OpenBioprinting/OpenLab/README.md

# OpenLab
Open Lab Tools for science

More documentation: http://openbioprinting.org/open-lab/
