OpenBioprinting/OpenLab/paste_extruder_HP2/README.md

CC-4.0-SA
Jan2019 Nicuma3

Derivative of "Harry's Paste Extruder by yoursstreuli Apr 3, 2015" at https://www.thingiverse.com/thing:754436 and "Greg wade accessible extruder/ AB_design by AB-Design Apr 20, 2018" https://www.thingiverse.com/thing:2868510

Adaptable to Prusa Hephestos 1 - BQ (https://www.bq.com/es/support/hephestos/support-sheet and https://github.com/bq/prusa-i3-hephestos)

### BOM (Bill of materials):

  - 1 x NEMA 17 step driver
  - 2 x M4xL70 mm threaded rod (DIN 975)
  - 1 x M4xL20 mm threaded rod (DIN 975)

  - 6 x M8 washer (DIN 125)
  - 4 x M4 Large OD washer (oversize) (DIN 9021)

  - 2 x M4 Wingnut (DIN 315)

  - 1 x M8xL60 mm bolt (DIN 933) - MUST BE CHAMFERED/MECHANIZE!

  - 1 x M3xL30 mm bolt (DIN 912)
  - 2 x M3xL40 mm bolt (DIN 912)

  - 3 x M3 nut (DIN 934)
  - 2 x M4 nut (DIN 934)

  - 1 x M3xL8 mm socket set screw (DIN 916)

  - 1 x M8 Hex lock nut (DIN 985)

  - 2 x Axial bearing 608zz (DIN 625)
  - 1 x Axial bearing 624zz (DIN 625)

  - 2 x springs 18x4mm (REF missing)

  - 6 Printed parts:
 	  - adapted internal gear
	  - base_support
	  - spring_press
	  - herringbone_large_gear
	  - heringbone_small_gear
	  - plunge

Assembly and more info at: openbioprinting.org
