OpenBioprinting/OpenLab/paste_extruder_HP2/drawings/readme.txt

The construction and assembly of the extruder is explained also here with subset drawings, that can also help with the manufacture of the extruder.
