OpenBioprinting/OpenLab/paste_extruder_HP2/Documentation/config_extruder.pdf

diy bioprinter: assembly and calibration

b.2 assembly

The assembly of the extruder is explained in the next pages, with subset drawings. Also, an interactive 3D model of the complete assemblied extruder can be consulted online:
https://a360.co/2EwcIV1.

b.3 calibration and software adaptation

To be able to work with the new extruder in any printer, we need to obtain some basic data from the mechanical transmission, to obtain the steps per unit. This is a parameter present in all the axis or a normal 3D printer that works with stepper motors. It represents how much must rotate the stepper motor to obtain a movement of 1 mm at the end of the transmision. For example, when the x, y or z-axis moves 1 mm. This number can be calculated following the movement of the mechanical parts conected to the motor.

In our case, the motor (which rotates 1.8◦per step) moves solidary with a small herringbone (double helical) gear [Piece 5]. Then a reduction system transforms this movement into a smaller rotation, but with higher torque. Solidary to this big herringbone gear [Piece 6], is a pinion [Piece 3] that translates the rotational movement to a linear one, thanks to a pinion-rack system. This rack [Piece 4] will act as the plunge that will press the syringe. Therefore, this is the final element of the transmission, the one that should move 1 mm.

The calculations requiered to obtain the number of steps that the motor must rotate to achieve this movement (steps_per_unit) are reflected in Figure B.1.

148

B.3 calibration and software adaptation

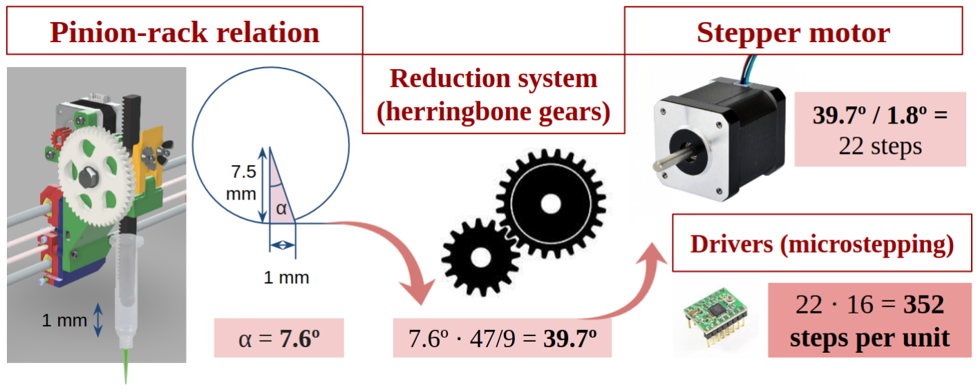
[picture p1: figure]

Figure B.1: Transmision movement scheme to calculate the ’steps per unit’ for the extruder motor. It may change for other printers microstepping.

b.3.1 Firmware adaptation - MARLIN

Marlin is composed by many files and libraries. In our case, we only need to use a Marlin adapted to our printer model, and made some chages at ’Configuration.h’.

1. # define TEMP_SENSOR_0 to 998: this will tell the printer that the current temperature of the extruder is 25 ◦C always. This is necessary to print, as we do not use the heating, neither the temperature sensor of the extruder.
2. # define EXTRUDE_MINTEMP to 20: to remove the limitation of printing only over 170 ◦C, that is normally preinstalled in the printers.
3. # define INVERT_E0_DIR to false: Only when necessary, if the extruder is moving in the opposite direction.
4. # define Z_RAISE_BEFORE_HOMING to n: tto avoid collision, if transwells or any other recipient is used for bioprinting. This can also be changed at ’Start G-Code’ inside the slicing software.
5. # define DEFAULT_AXIS_STEPS_PER_UNIT (x,y,z, E): where (x,y,z) is given by default depending on the printer model and E is changed

149 diy bioprinter: assembly and calibration

to 352² to set up the correct volume deposition. This number is given by the movement translation from the rotating advance of the stepper motor to the linear movement of the plundge that press the syringe with the paste, as explained in Figure B.1.

b.3.2 Slicing program - Cura

This annex will describe the configuration requiered in the slicing software (Cura, Ultimaker) to generate the trajectories (.gcodes) and deposit the correct volume of paste.

In the first place, we need to access the printer settings menu and change the configuration of the ’compatible filament diameter’ to 18 mm, which is normally the diameter of the 10 cc cartridge / syringe.

The, at Filament menu, we introduce again this number (18 mm) where the size of the filament plastic used is normally configured. We need to change also the temperature required for the thermoplastic melting to the 25◦C, and configure the temperature of the hot base if required.

In the printing menu configuration we need to check also some submenus:

– Retraction: The cartridge diameter, which along with the mm extruded give us the volume of material that enters in the system. In our case, the Nordson cartridges are set to 18 mm.
– Bed temperature: 37 ◦C, if cells are present.
– Layer height: 65% of the noozle/needle tip diameter.
– Retraction: Disabled, to avoid the introduction of air inside the cartridges

2 This number can change if other microstepping relation is used by the printer electronics board.

150
