OpenBioprinting/OpenLab/paste_extruder_HP2/plunge barrel 10 cc.stl

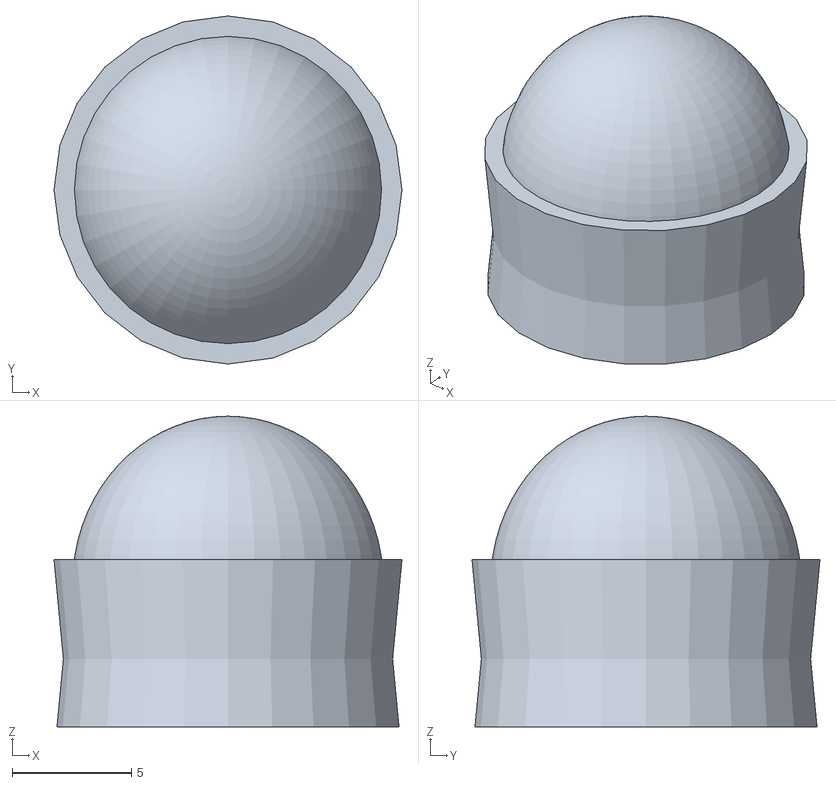
[picture p2: CAD file, 2019-07-03]
paste_extruder_HP2/plunge barrel 10 cc.stl
14.6 x 14.6 x 13.0
