OpenBioprinting/OpenLab/paste_extruder_HP2/taper tip.stl

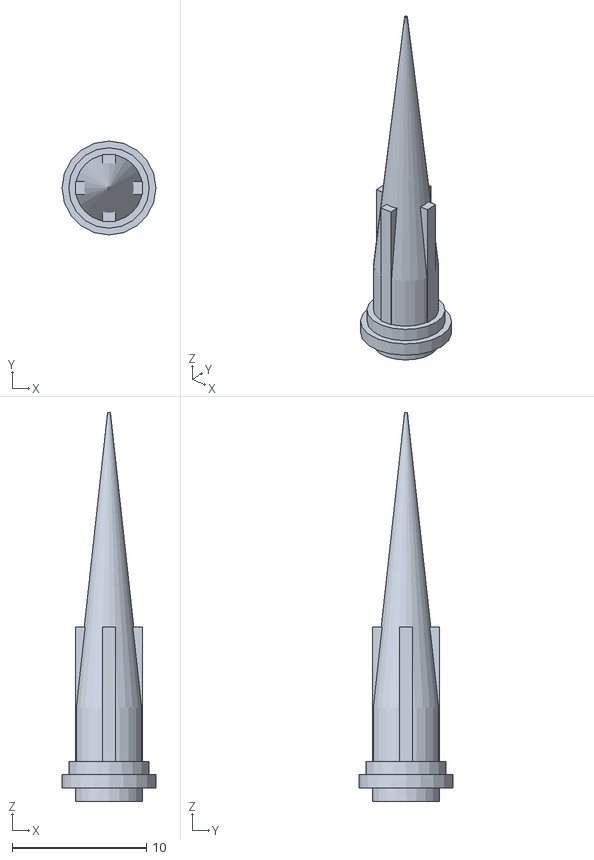
[picture p3: CAD file, 2019-07-03]
paste_extruder_HP2/taper tip.stl
7.00 x 7.00 x 29.0
