OpenBioprinting/OpenLab/paste_extruder_HP2/adapted_internal_gear.stl

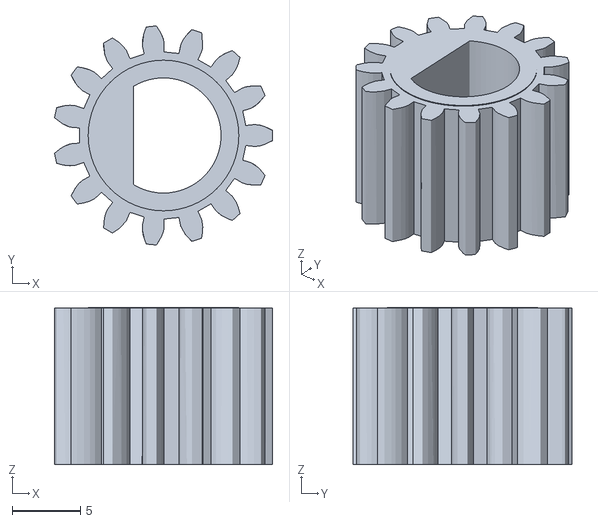
[picture p4: CAD file, 2019-07-03]
paste_extruder_HP2/adapted_internal_gear.stl
15.9 x 16.0 x 11.5
