OpenBioprinting/OpenLab/paste_extruder_HP2/base_support.stl

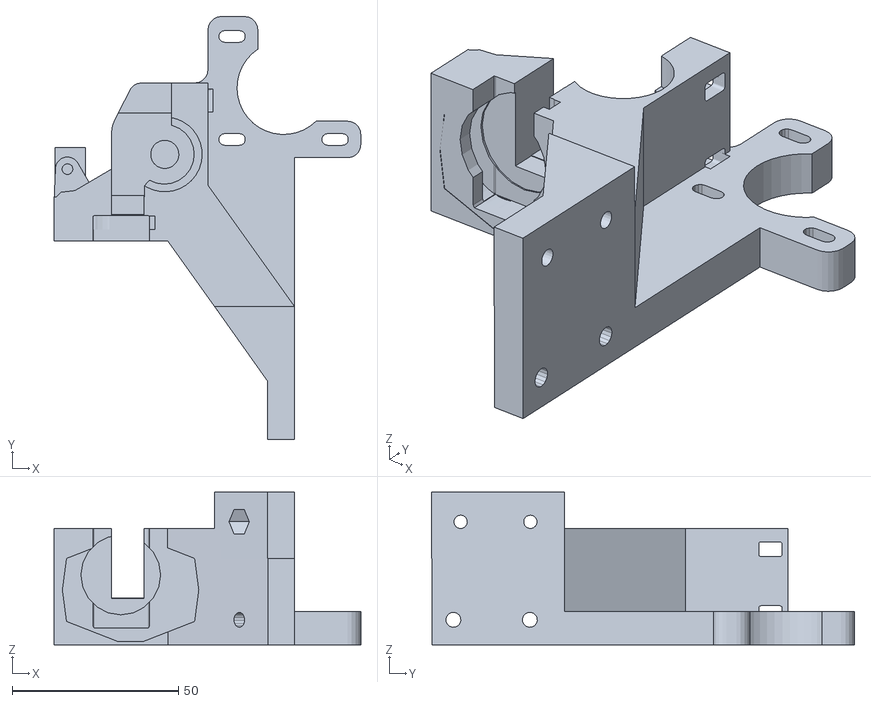
[picture p5: CAD file, 2019-07-02]
paste_extruder_HP2/base_support.stl
92.3 x 127.3 x 45.9
