OpenBioprinting/OpenLab/paste_extruder_HP2/herringbone_large_gear.stl

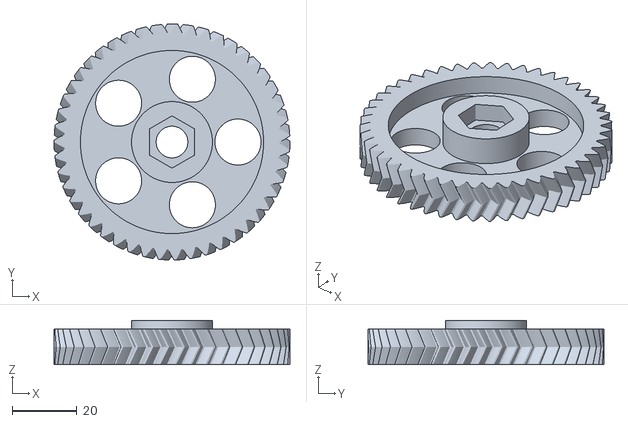
[picture p6: CAD file, 2019-07-02]
paste_extruder_HP2/herringbone_large_gear.stl
73.0 x 73.0 x 13.8
