OpenBioprinting/OpenLab/paste_extruder_HP2/herringbone_small_gear.stl

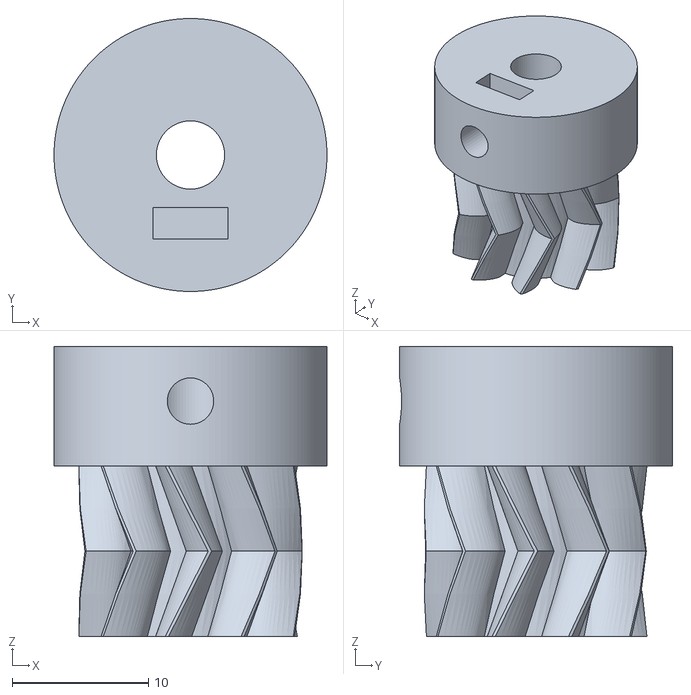
[picture p7: CAD file, 2019-07-02]
paste_extruder_HP2/herringbone_small_gear.stl
20.0 x 20.0 x 21.2
