OpenBioprinting/OpenLab/paste_extruder_HP2/spring_press.stl

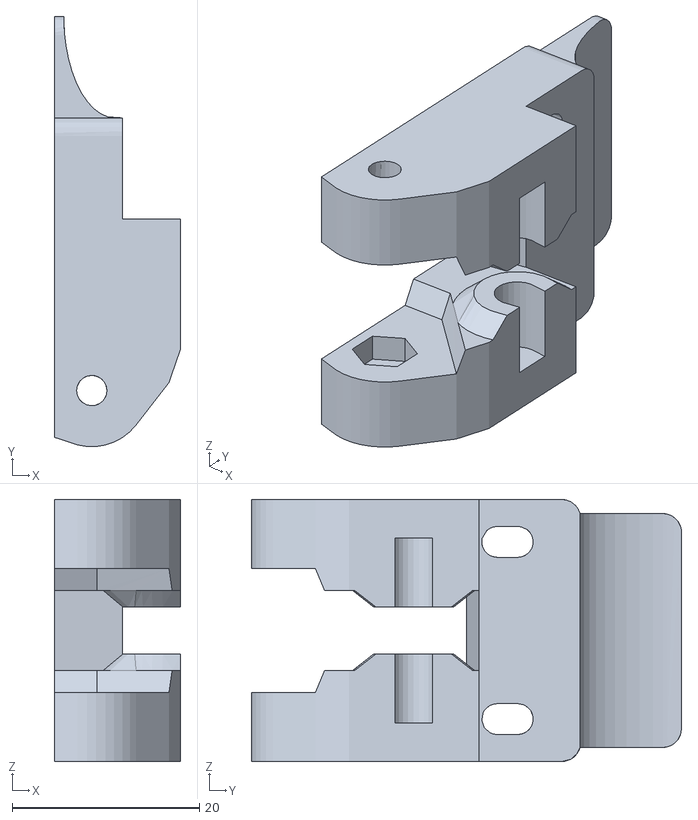
[picture p8: CAD file, 2019-07-02]
paste_extruder_HP2/spring_press.stl
13.5 x 46.0 x 28.0
