OpenBioprinting/OpenLab/paste_extruder_HP2/plunge.stl

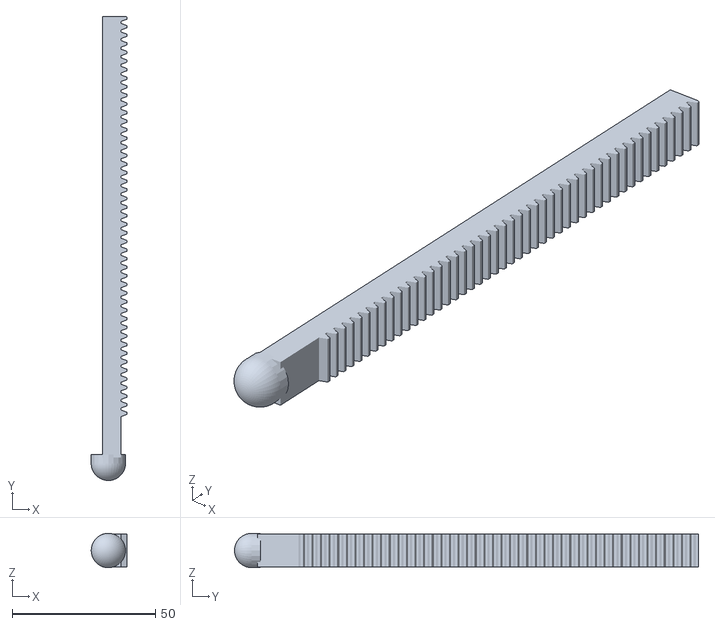
[picture p9: CAD file, 2019-07-02]
paste_extruder_HP2/plunge.stl
12.5 x 162.0 x 12.0
