OpenBioprinting/OpenLab/paste_extruder_HP2/drawings/10-Spring_Press_Color.pdf

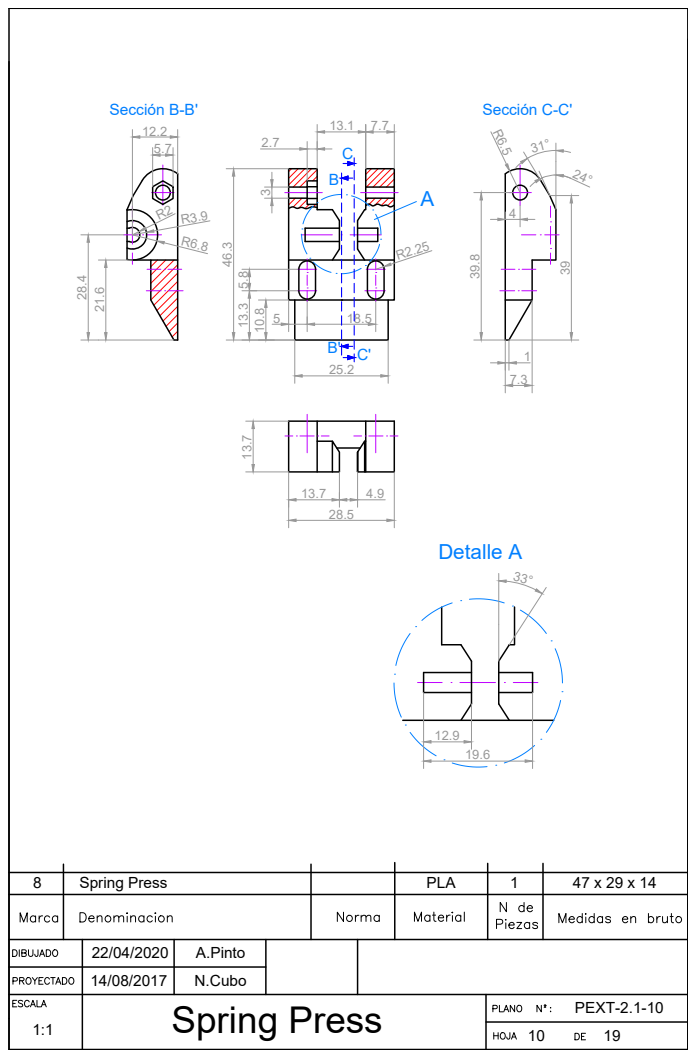
[picture p10: page 1]
Spring Press; Detalle A; Sección C-C'; Sección B-B'

22/04/2020 | A.Pinto

14/08/2017 | N.Cubo
