OpenBioprinting/OpenLab/paste_extruder_HP2/drawings/11-Stepper_Motor_Color.pdf

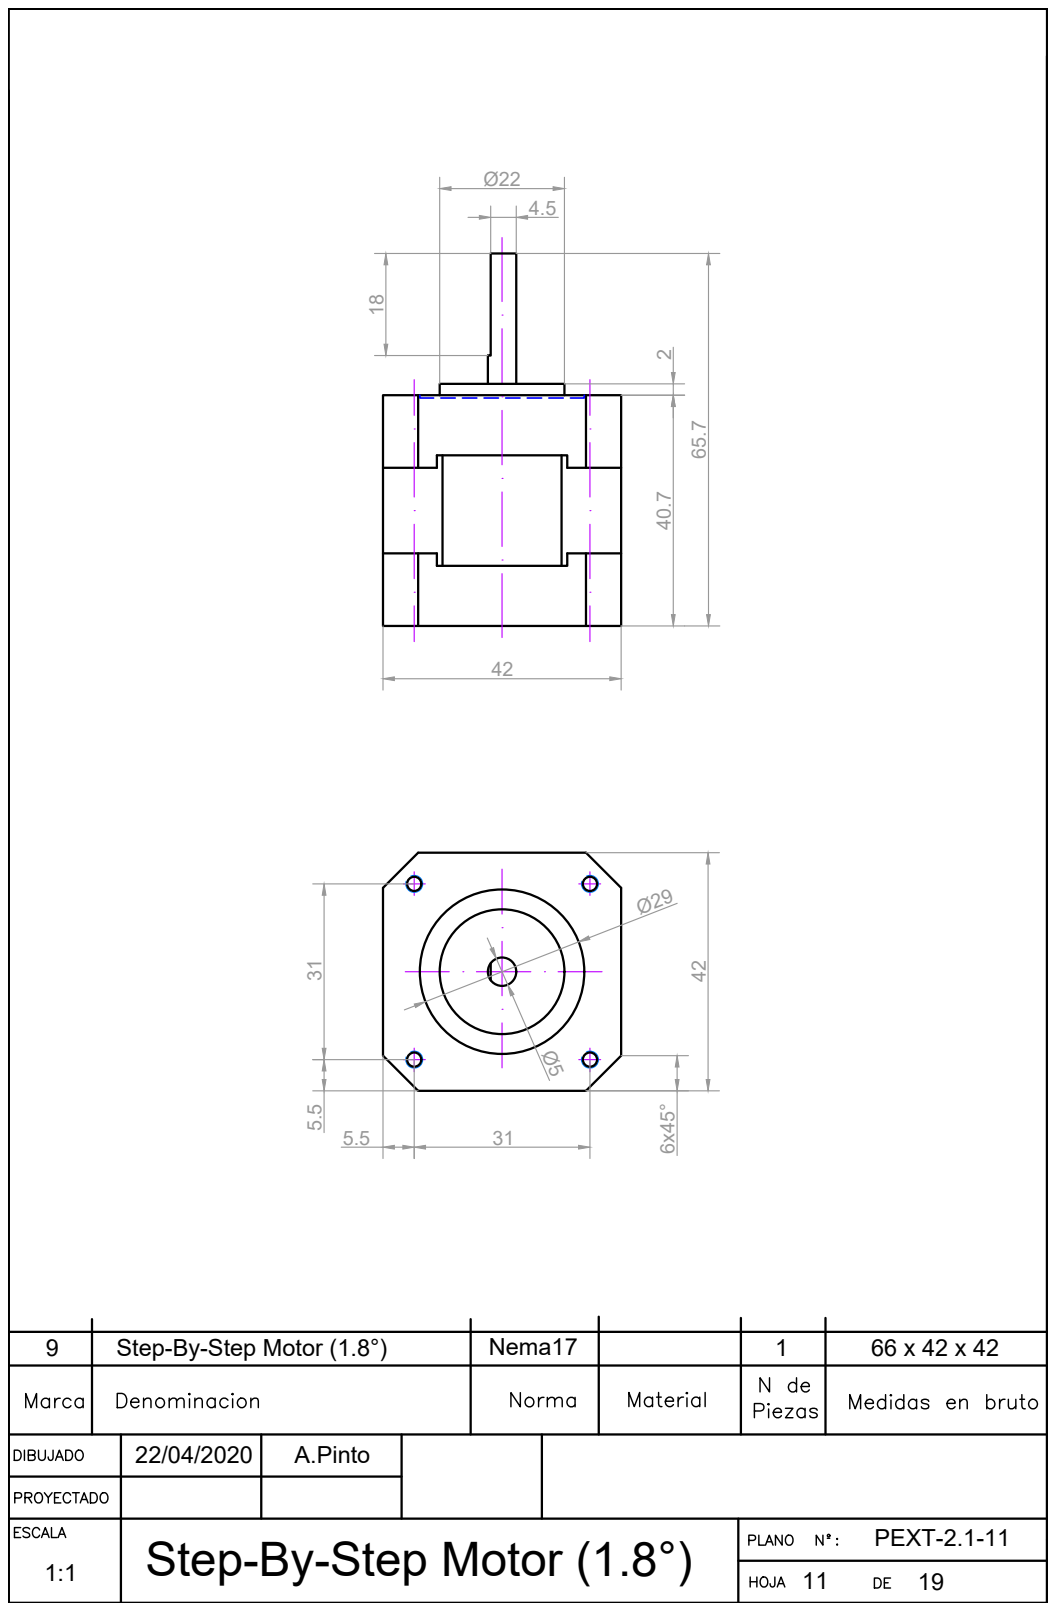
[picture p11: page 1]
Step-By-Step Motor (1.8°) 42

Step-By-Step Motor (1.8°)
