OpenBioprinting/OpenLab/paste_extruder_HP2/drawings/12-Normalized_Elements_1_Color.pdf

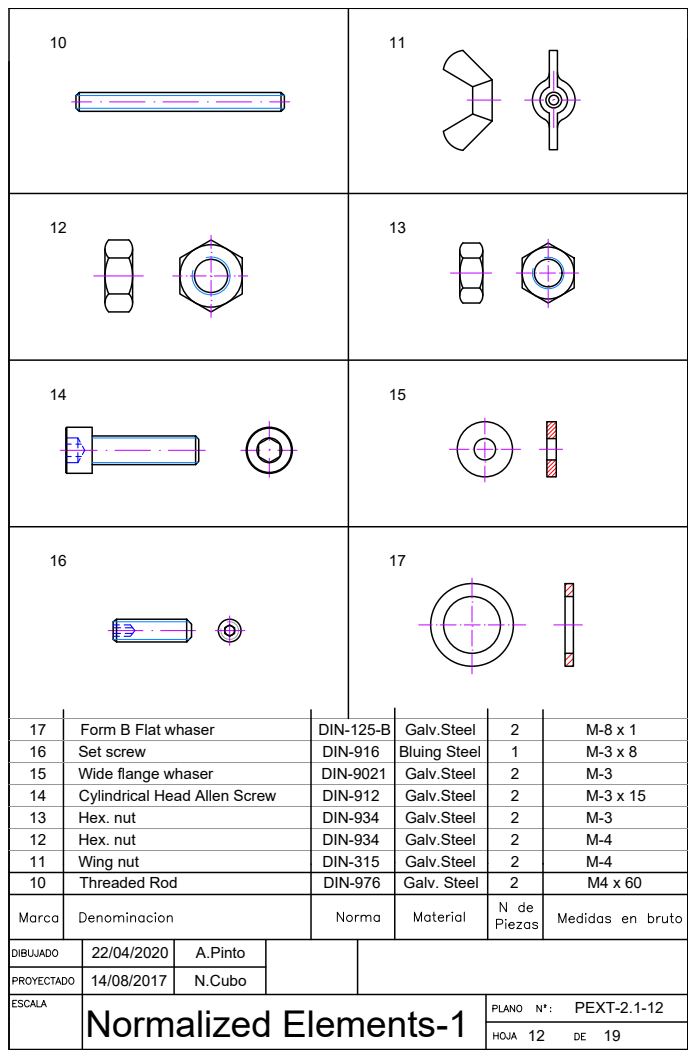
[picture p12: page 1]
Normalized Elements-1

17 | Form B Flat whaser | DIN-125-B | Galv.Steel | 2 | M-8 x 1
16 | Set screw | DIN-916 | Bluing Steel | 1 | M-3 x 8
15 | Wide flange whaser | DIN-9021 | Galv.Steel | 2 | M-3
14 | Cylindrical Head Allen Screw | DIN-912 | Galv.Steel | 2 | M-3 x 15
13 | Hex. nut | DIN-934 | Galv.Steel | 2 | M-3
12 | Hex. nut | DIN-934 | Galv.Steel | 2 | M-4
11 | Wing nut | DIN-315 | Galv.Steel | 2 | M-4
10 | Threaded Rod | DIN-976 | Galv. Steel | 2 | M4 x 60

22/04/2020 | A.Pinto

14/08/2017 | N.Cubo
