OpenBioprinting/OpenLab/paste_extruder_HP2/drawings/13-Normalized_Elements_2_Color.pdf

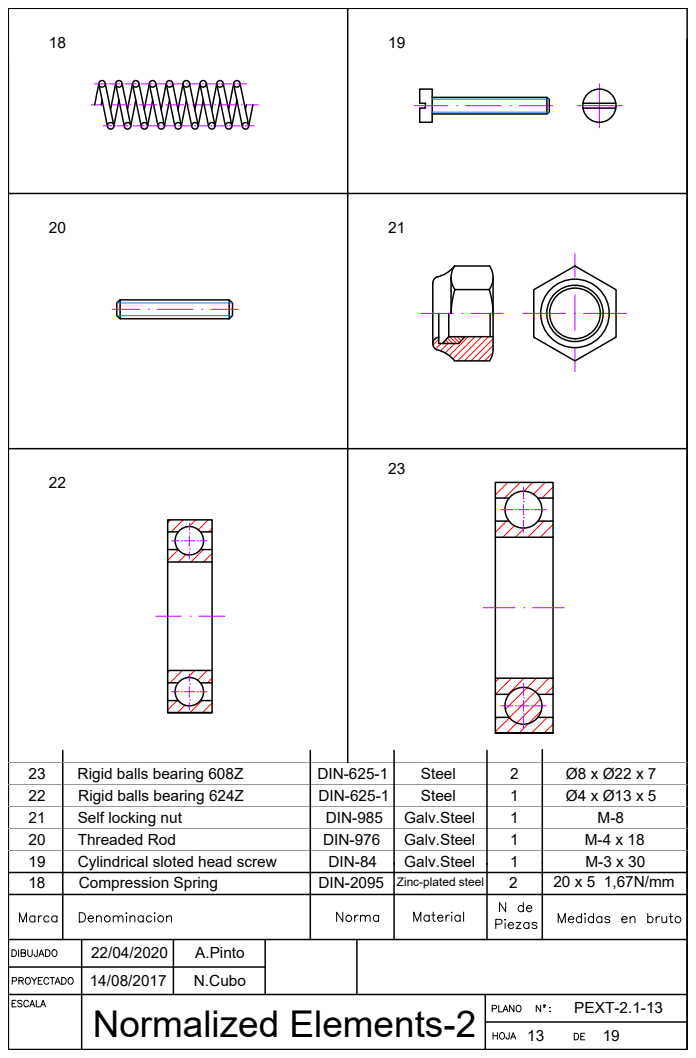
[picture p13: page 1]
Normalized Elements-2

23 | Rigid balls bearing 608Z | DIN-625-1 | Steel | 2 | Ø8 x Ø22 x 7
22 | Rigid balls bearing 624Z | DIN-625-1 | Steel | 1 | Ø4 x Ø13 x 5
21 | Self locking nut | DIN-985 | Galv.Steel | 1 | M-8
20 | Threaded Rod | DIN-976 | Galv.Steel | 1 | M-4 x 18
19 | Cylindrical sloted head screw | DIN-84 | Galv.Steel | 1 | M-3 x 30
18 | Compression Spring | DIN-2095 | Zinc-plated steel | 2 | 20 x 5 1,67N/mm

22/04/2020 | A.Pinto

14/08/2017 | N.Cubo
