OpenBioprinting/OpenLab/paste_extruder_HP2/drawings/14-Subset_1_Color.pdf

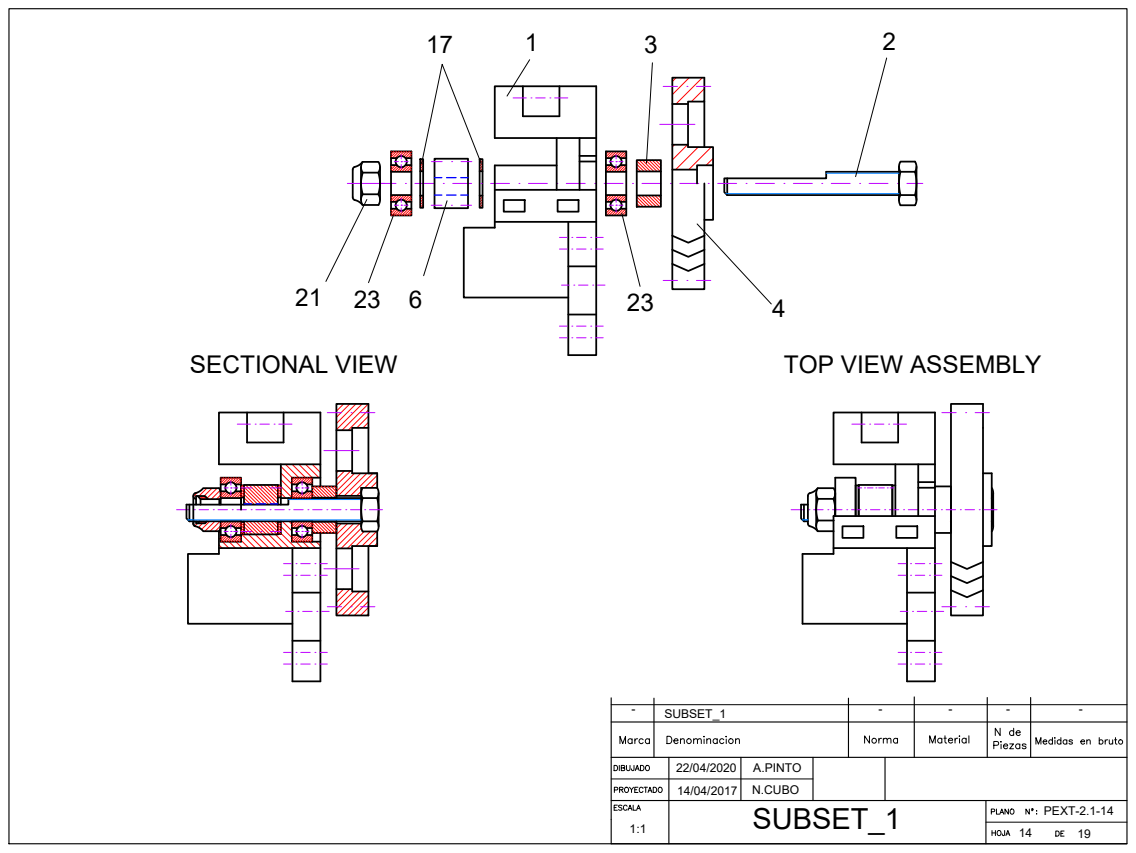
[picture p14: page 1]
SECTIONAL VIEW; TOP VIEW ASSEMBLY
