OpenBioprinting/OpenLab/paste_extruder_HP2/drawings/15-Subset_2_Color.pdf

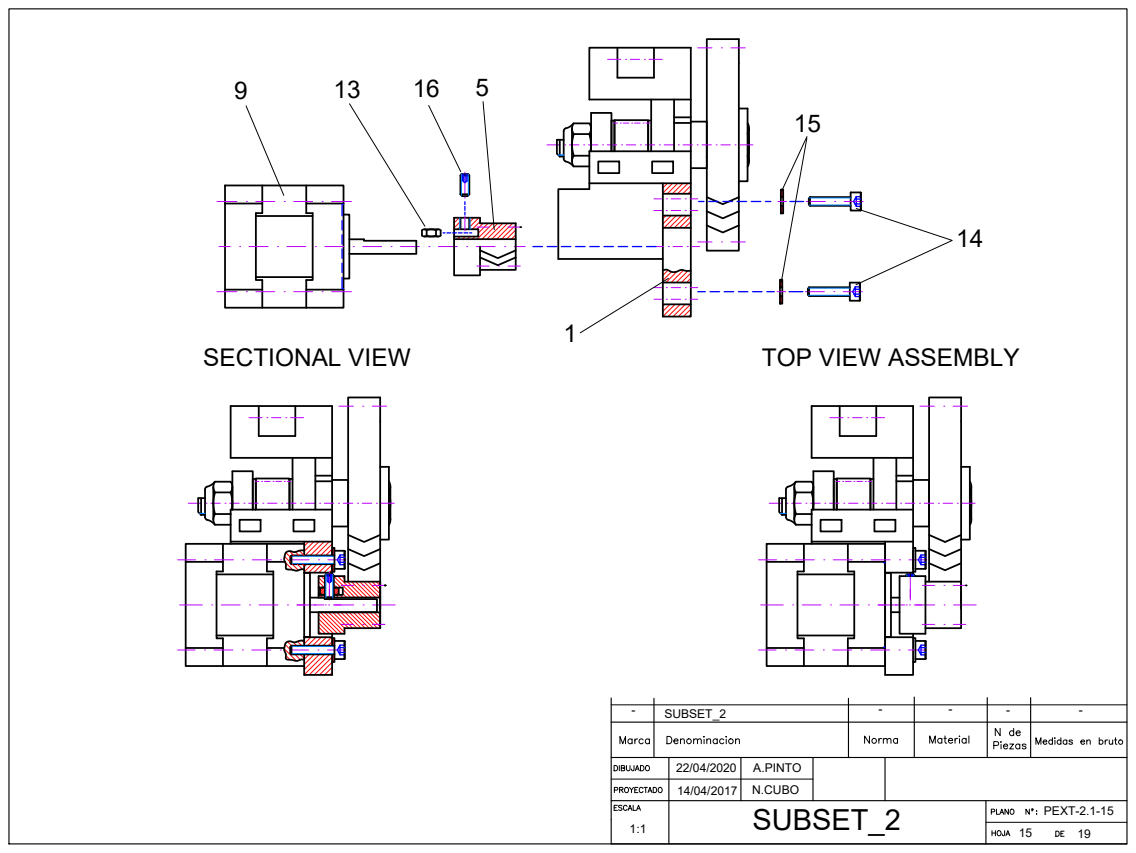
[picture p15: page 1]
SECTIONAL VIEW; TOP VIEW ASSEMBLY
