OpenBioprinting/OpenLab/paste_extruder_HP2/drawings/16-Subset_3_Color.pdf

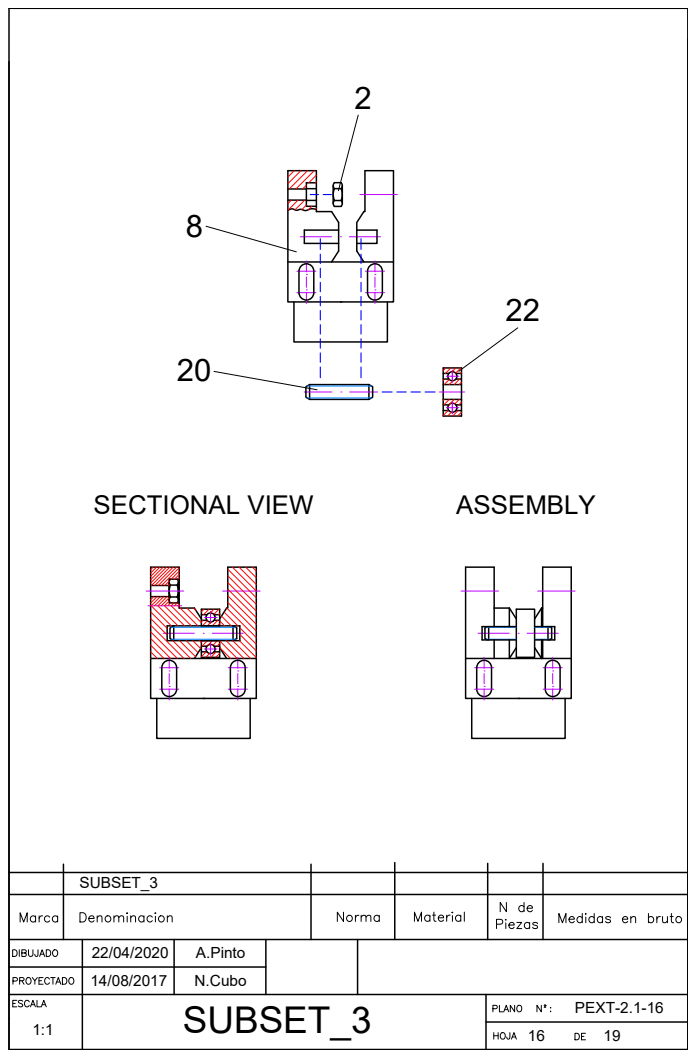
[picture p16: page 1]
SECTIONAL VIEW; ASSEMBLY

22/04/2020 | A.Pinto

14/08/2017 | N.Cubo
