OpenBioprinting/OpenLab/paste_extruder_HP2/drawings/17-Subset_4_Color.pdf

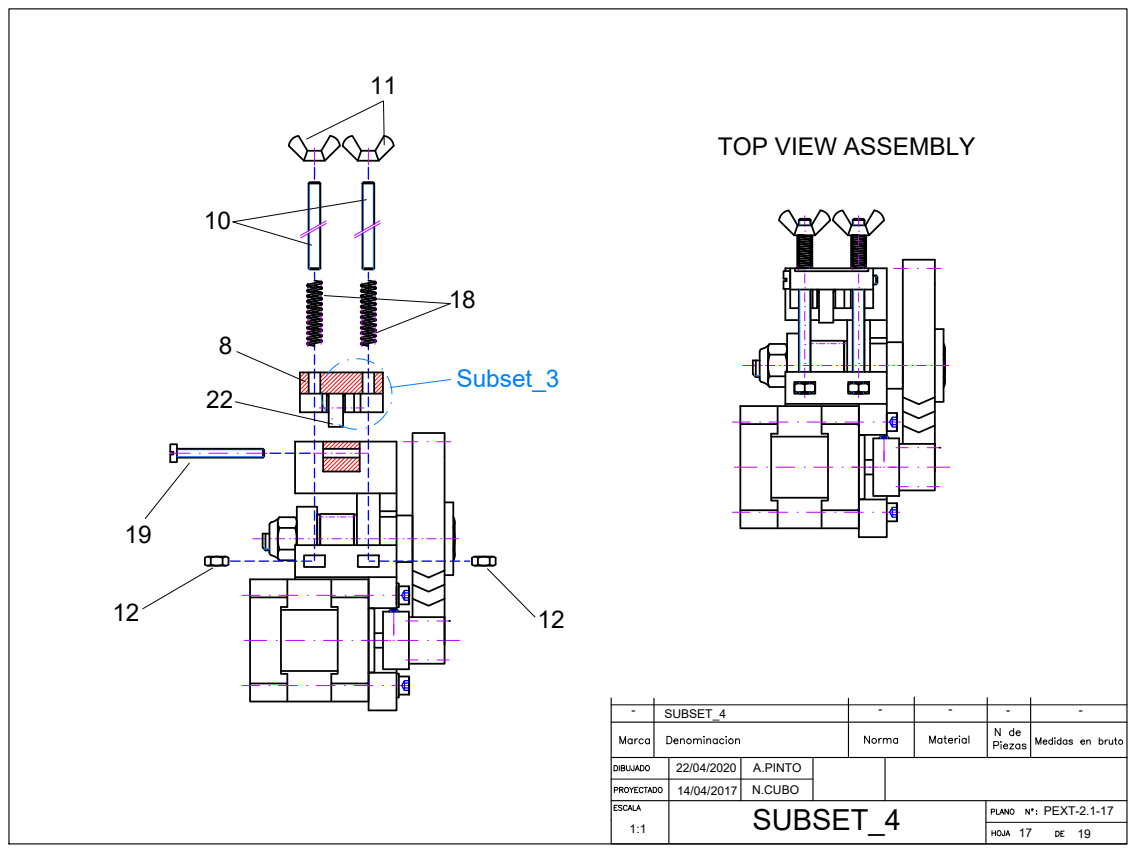
[picture p17: page 1]

TOP VIEW ASSEMBLY
