OpenBioprinting/OpenLab/paste_extruder_HP2/drawings/18-Subset_5_Color.pdf

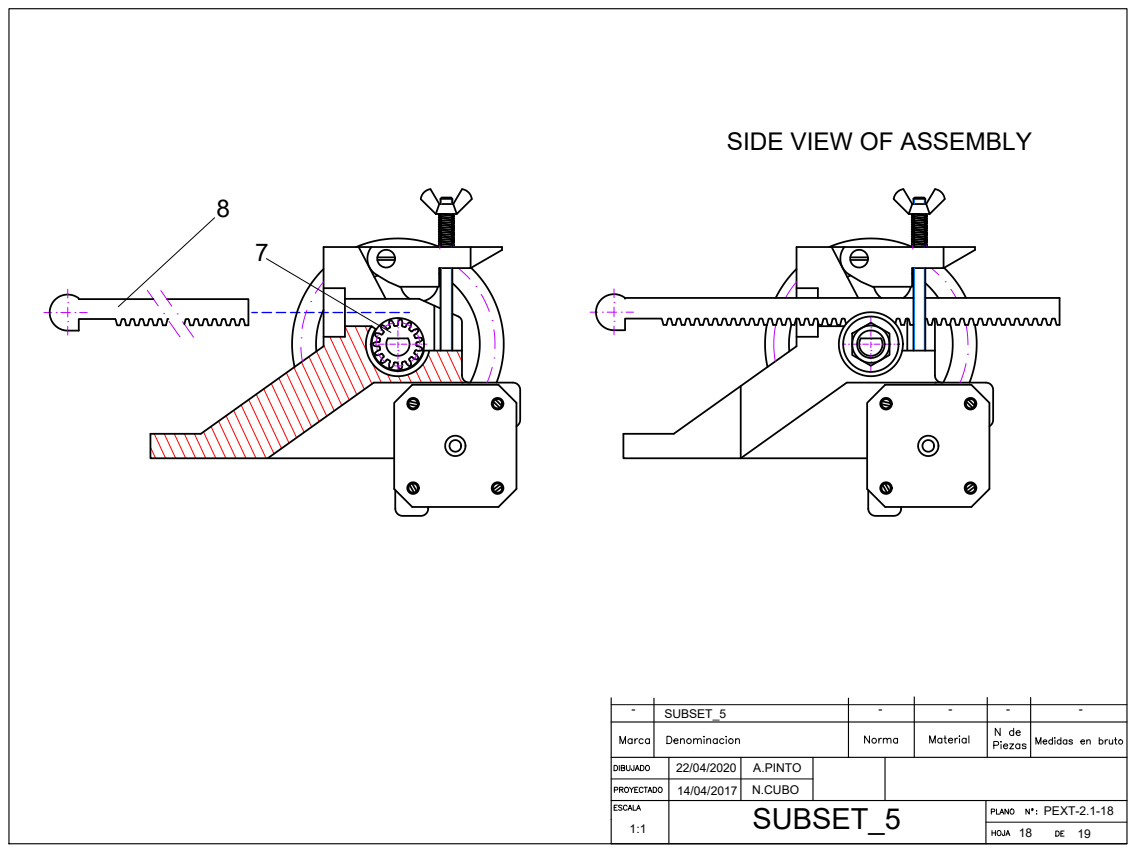
[picture p18: page 1]

SIDE VIEW OF ASSEMBLY
