OpenBioprinting/OpenLab/paste_extruder_HP2/drawings/2-Milled_Screw_Color.pdf

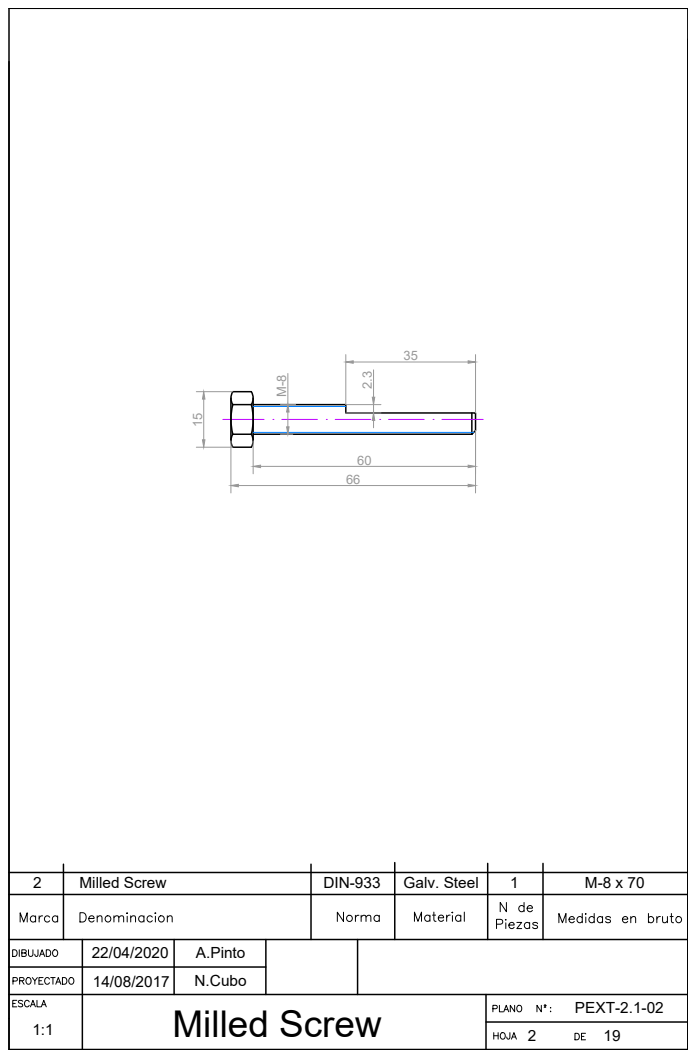
[picture p19: page 1]
DIN-933; Galv. Steel; Milled Screw

22/04/2020 | A.Pinto

14/08/2017 | N.Cubo
