OpenBioprinting/OpenLab/paste_extruder_HP2/drawings/6-Motor_Transmission_Color.pdf

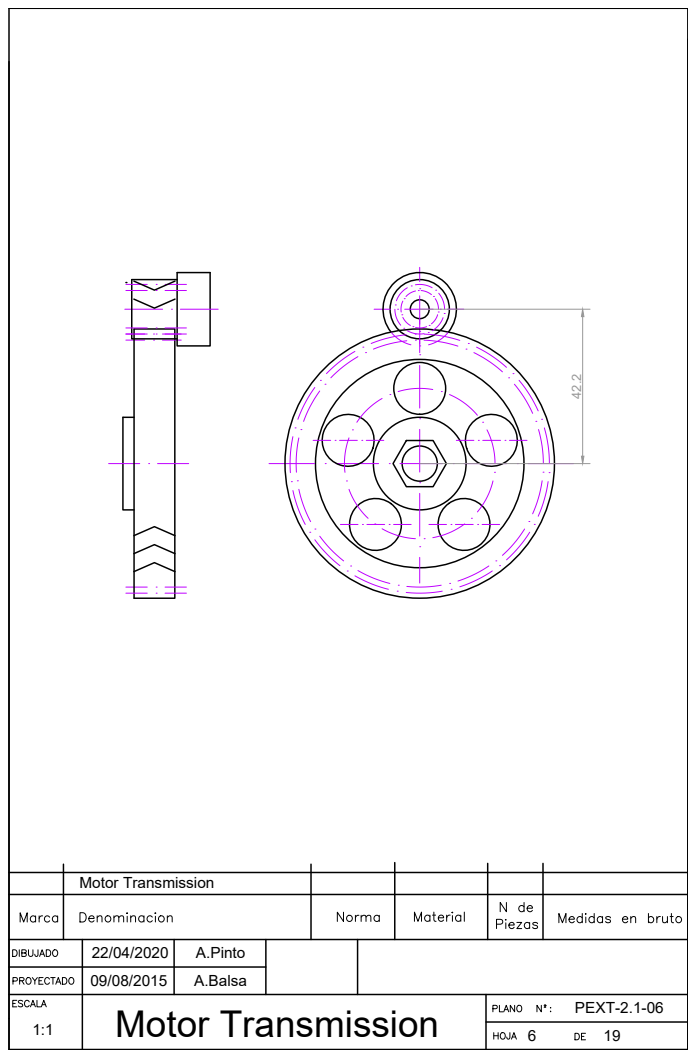
[picture p21: page 1]
Motor Transmission

22/04/2020 | A.Pinto

09/08/2015 | A.Balsa
