OpenBioprinting/OpenLab/paste_extruder_HP2/drawings/19-Extruder_Assembly_Color.pdf

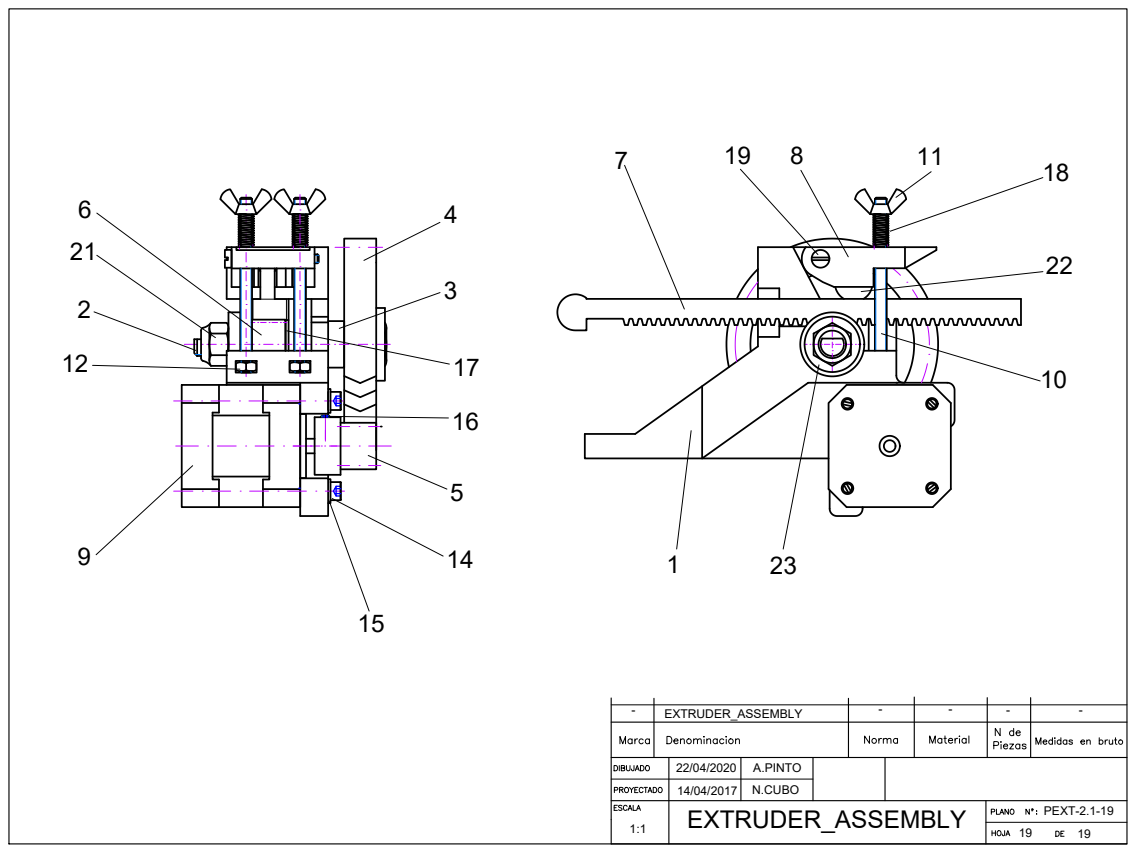
[picture p22: page 1]
