OpenBioprinting/OpenLab/paste_extruder_HP2/drawings/1-Base_Support_Color.pdf

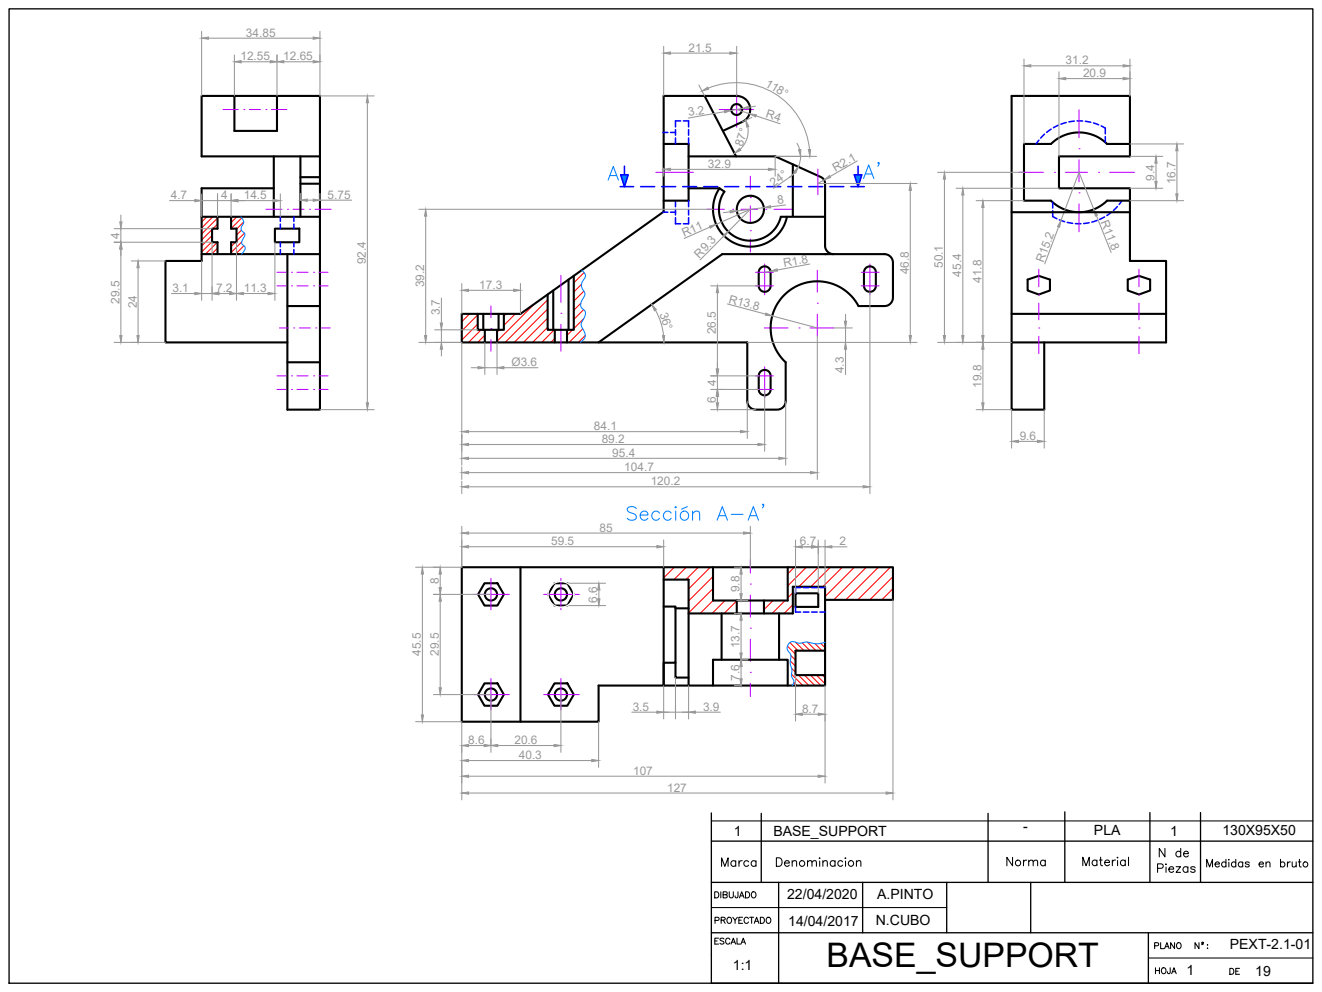
[picture p23: page 1]

22/04/2020 | A.PINTO
1:1 | BASE_SUPPORT | PEXT-2.1-01

14/04/2017 | N.CUBO
