OpenBioprinting/OpenLab/paste_extruder_HP2/drawings/3-Spacer_Color.pdf

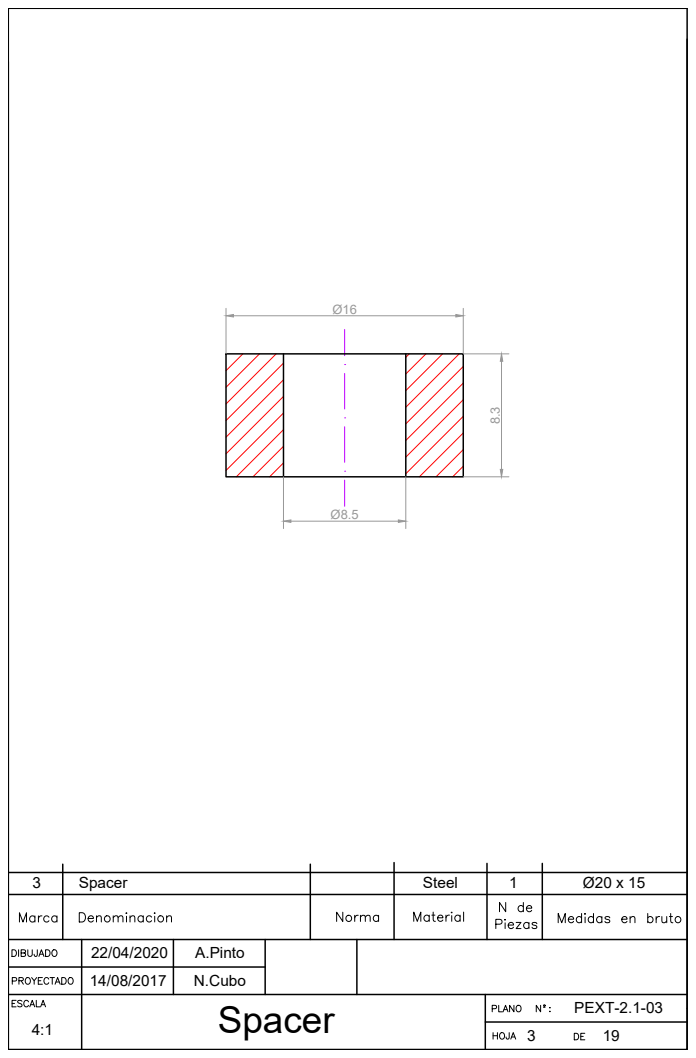
[picture p24: page 1]

22/04/2020 | A.Pinto

14/08/2017 | N.Cubo
