OpenBioprinting/OpenLab/paste_extruder_HP2/drawings/5-Small_Gear_Color.pdf

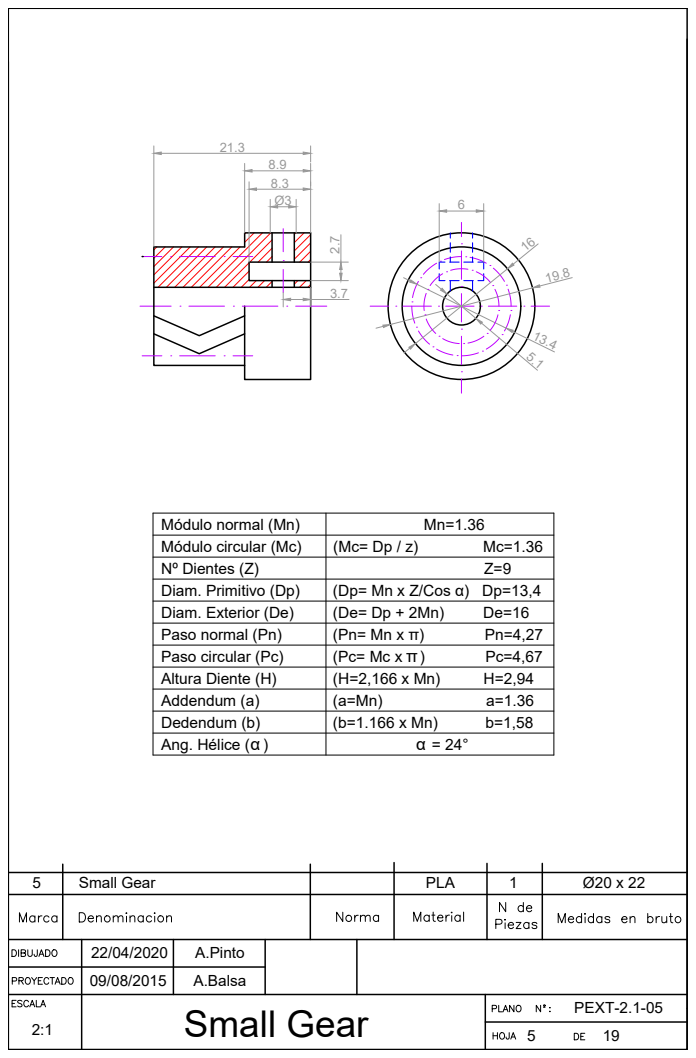
[picture p25: page 1]
Small Gear

Módulo normal (Mn) | Mn=1.36
Módulo circular (Mc) | (Mc= Dp / z) Mc=1.36
Nº Dientes (Z) | Z=9
Diam. Primitivo (Dp) | (Dp= Mn x Z/Cos α) Dp=13,4
Diam. Exterior (De) | (De= Dp + 2Mn) De=16
Paso normal (Pn) | (Pn= Mn x π) Pn=4,27
Paso circular (Pc) | (Pc= Mc x ) π Pc=4,67
Altura Diente (H) | (H=2,166 x Mn) H=2,94
Addendum (a) | (a=Mn) a=1.36
Dedendum (b) | (b=1.166 x Mn) b=1,58
Ang. Hélice ( ) α | α = 24°

22/04/2020 | A.Pinto

09/08/2015 | A.Balsa
