OpenBioprinting/OpenLab/paste_extruder_HP2/drawings/7-Internal_Gear_Color.pdf

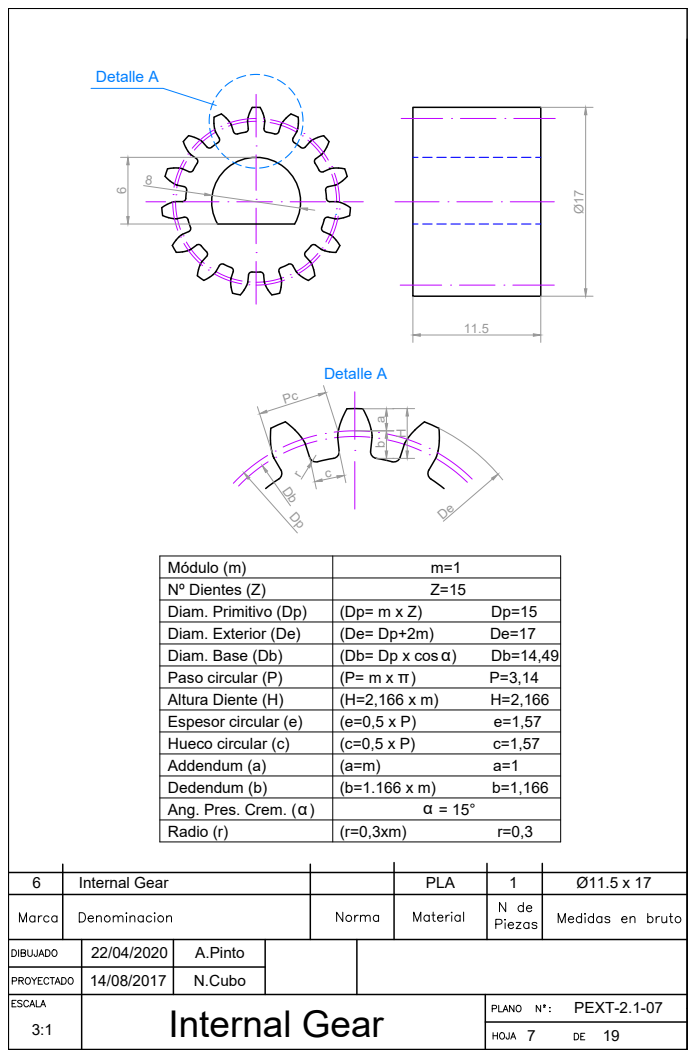
[picture p26: page 1]
Internal Gear; Detalle A

Módulo (m) | m=1
Nº Dientes (Z) | Z=15
Diam. Primitivo (Dp) | (Dp= m x Z) Dp=15
Diam. Exterior (De) | (De= Dp+2m) De=17
Diam. Base (Db) | (Db= Dp x cos ) α Db=14,49
Paso circular (P) | π (P= m x ) P=3,14
Altura Diente (H) | (H=2,166 x m) H=2,166
Espesor circular (e) | (e=0,5 x P) e=1,57
Hueco circular (c) | (c=0,5 x P) c=1,57
Addendum (a) | (a=m) a=1
Dedendum (b) | (b=1.166 x m) b=1,166
Ang. Pres. Crem. ( ) α | α = 15°
Radio (r) | (r=0,3xm) r=0,3

22/04/2020 | A.Pinto

14/08/2017 | N.Cubo
