OpenBioprinting/OpenLab/paste_extruder_HP2/drawings/8-Plunge_Color.pdf

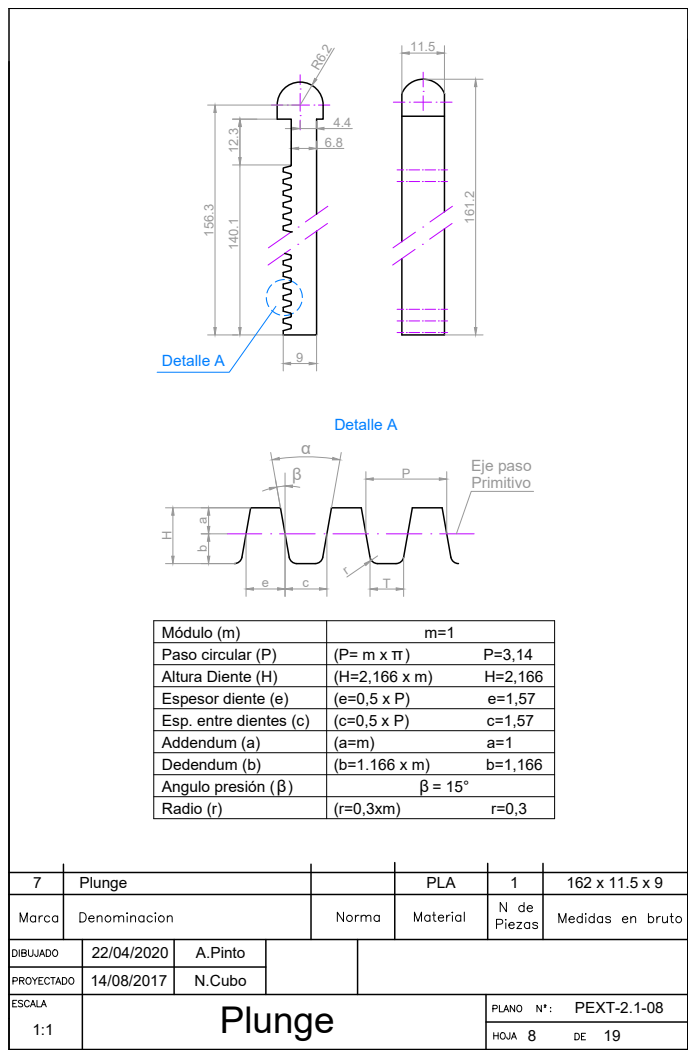
[picture p27: page 1]
Detalle A; Eje paso

Módulo (m) | m=1
Paso circular (P) | (P= m x ) π P=3,14
Altura Diente (H) | (H=2,166 x m) H=2,166
Espesor diente (e) | (e=0,5 x P) e=1,57
Esp. entre dientes (c) | (c=0,5 x P) c=1,57
Addendum (a) | (a=m) a=1
Dedendum (b) | (b=1.166 x m) b=1,166
Angulo presión ( ) β | β = 15°
Radio (r) | (r=0,3xm) r=0,3

22/04/2020 | A.Pinto

14/08/2017 | N.Cubo
