OpenBioprinting/OpenLab/paste_extruder_HP2/drawings/9-Rack_Transmission_Color.pdf

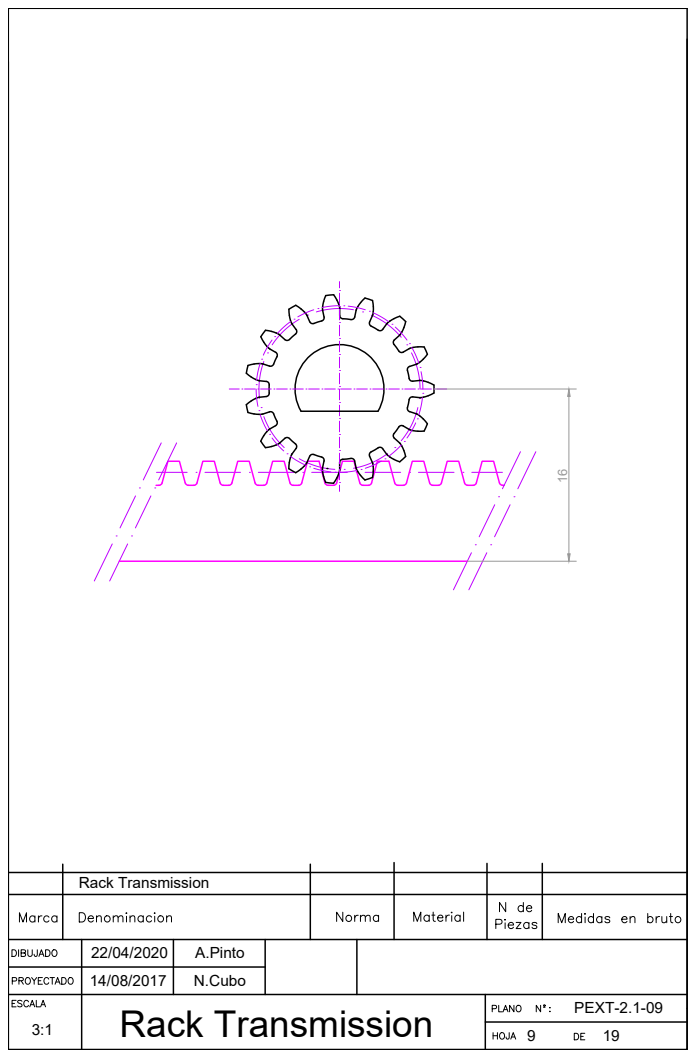
[picture p28: page 1]
Rack Transmission

22/04/2020 | A.Pinto

14/08/2017 | N.Cubo
