OpenBioprinting/OpenLab/(commit log)

2019-07-02 Paste extruder added
    Main parts of the paste extruder addapted to HP2 added. Work in progress
    [base_support.stl, big_gear.stl, herringbone_large_gear.stl, herringbone_small_gear.stl, plunge.stl, small_gear.stl, spring_press.stl]
2019-07-03 more elements (barrel,tip,m8bolt,608z,internalgear) added to the model
    [adapted_internal_gear.stl, plunge barrel 10 cc.stl, taper tip.stl]
2019-07-03 corrections plus lock nut
2019-08-18 Delete small_gear.stl
    Deprecated piece
    [small_gear.stl]
2019-11-20 removal of old versions. Added new BOM
    Files update and cleaning
    [big_gear.stl, small_gear.stl]
2019-11-20 NEMA added. readme updated with new BOM
2020-03-10 Delete big_gear.stl
    Deprecated
    [big_gear.stl]
2020-09-23 PDF extruder config
2021-01-14 Extruder config added
    Added configuration file from PhD Thesis
